AhmedDoesCS/wearable-health-monitor/docs/images/2026-01-22/1000065675.jpg

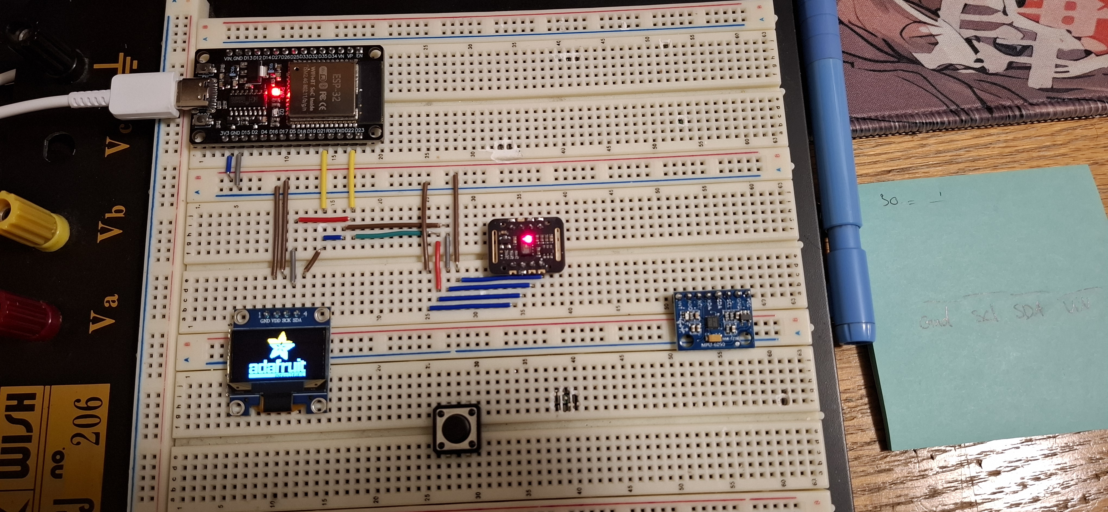
docs/images/2026-01-22/1000065675.jpg
