AhmedDoesCS/wearable-health-monitor/docs/SSD1306_notes.md

# SSD1306 — Integration Notes

## I2C Interface
- Address: 0x3C
