AhmedDoesCS/wearable-health-monitor/docs/images/2026-01-13/Schematic progress.png

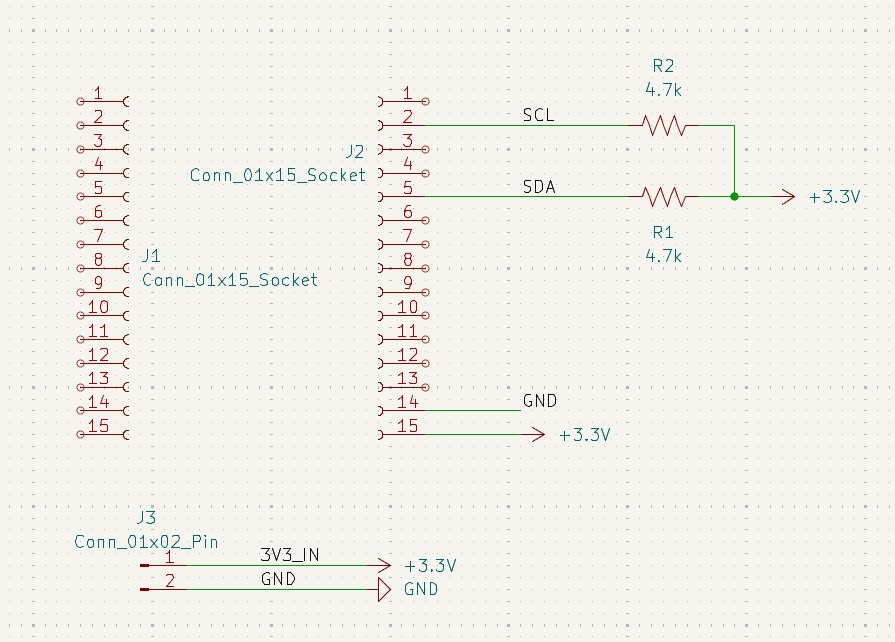
docs/images/2026-01-13/Schematic progress.png
