AhmedDoesCS/wearable-health-monitor/docs/images/2026-01-14/Schematic progress.png

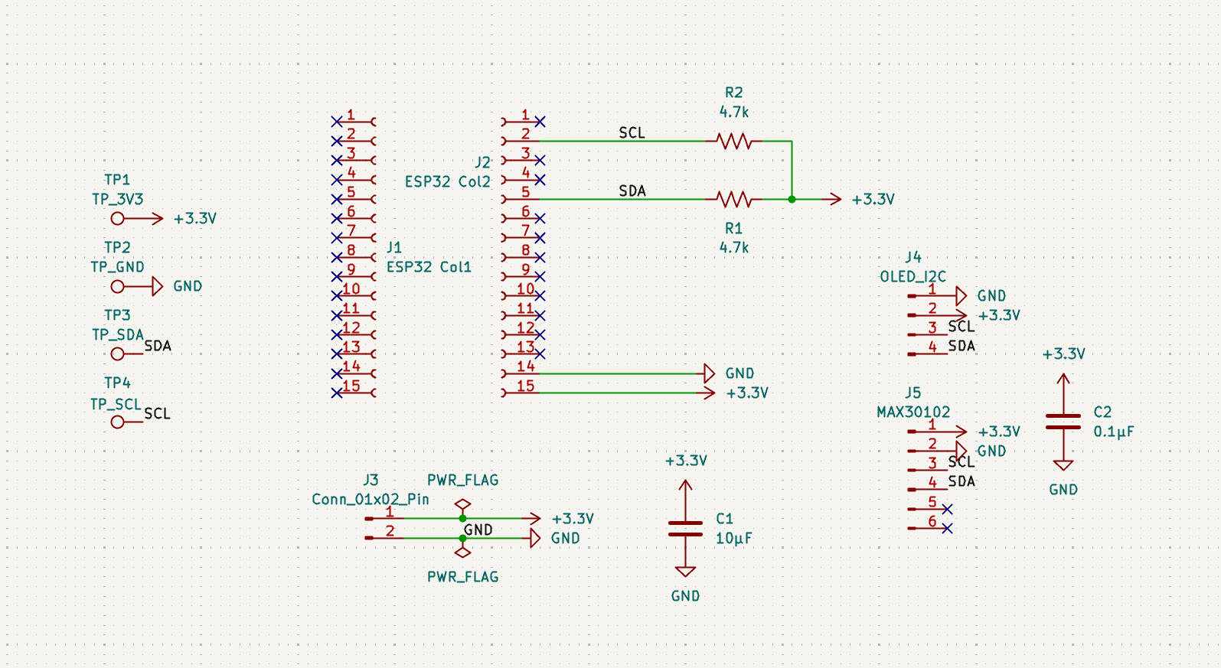
docs/images/2026-01-14/Schematic progress.png
