AhmedDoesCS/wearable-health-monitor/docs/images/2026-01-15/Assigned footprints for Rev A v1.png

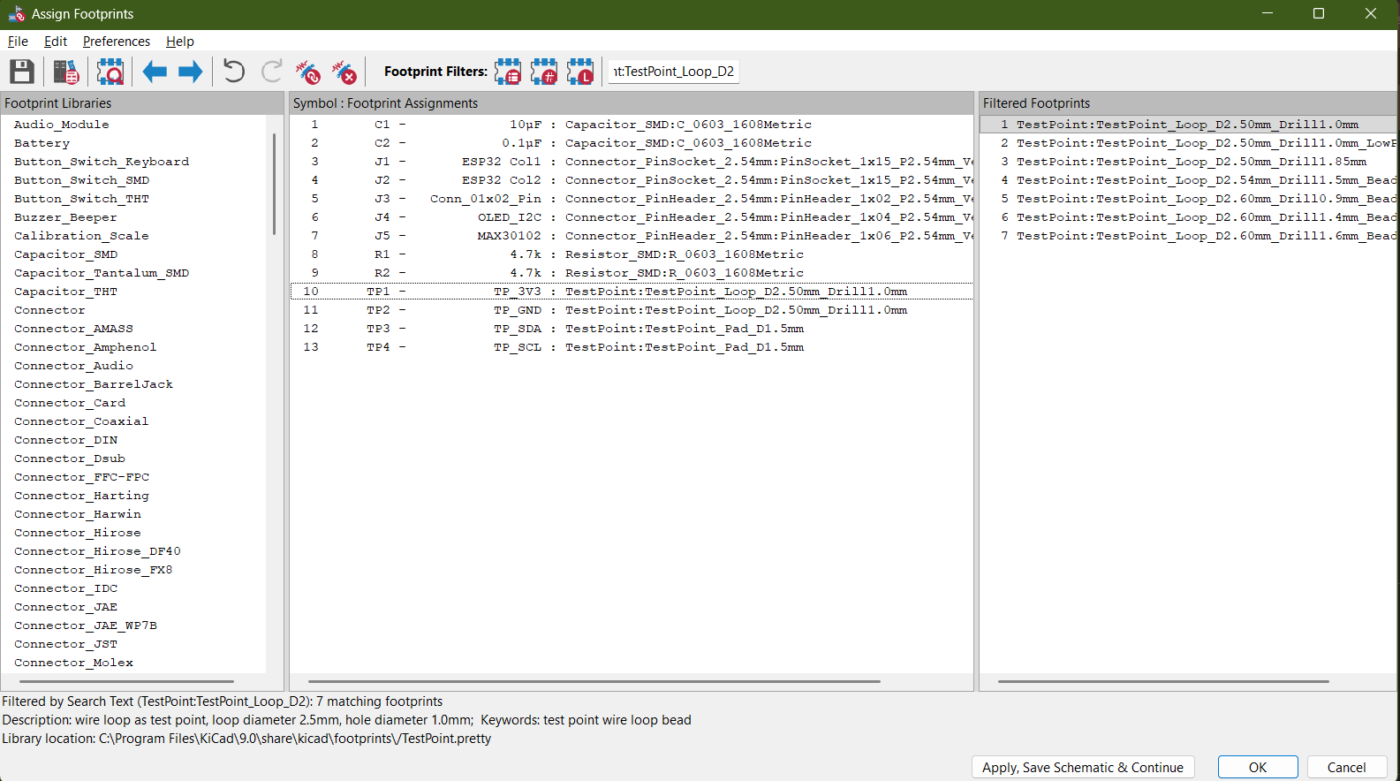
docs/images/2026-01-15/Assigned footprints for Rev A v1.png
