AhmedDoesCS/wearable-health-monitor/docs/images/2026-01-15/Rev A v1 progress 2.png

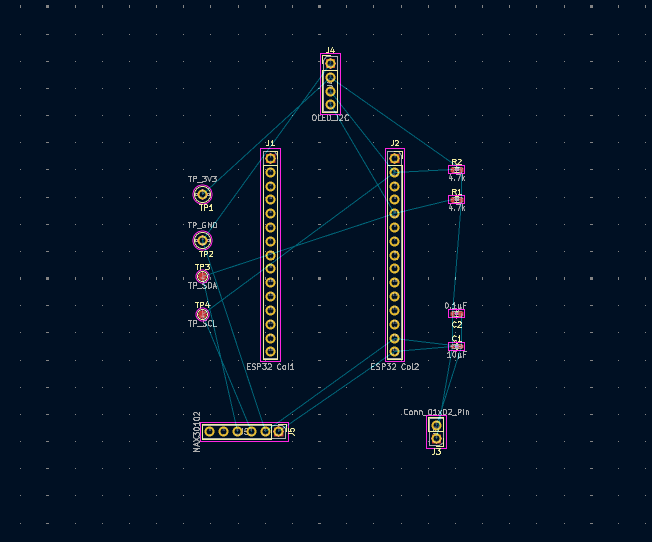
docs/images/2026-01-15/Rev A v1 progress 2.png
