AhmedDoesCS/wearable-health-monitor/docs/images/2026-01-21/1000065483.jpg

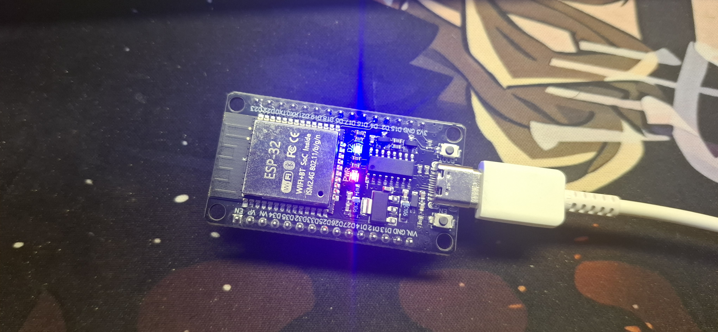
docs/images/2026-01-21/1000065483.jpg
