AhmedDoesCS/wearable-health-monitor/docs/images/2026-01-21/1000065524.jpg

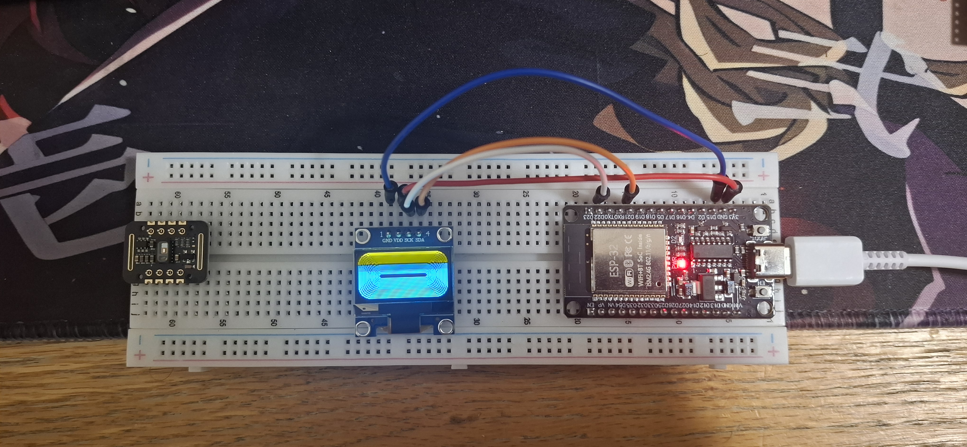
docs/images/2026-01-21/1000065524.jpg
