AhmedDoesCS/wearable-health-monitor/hardware/wearable_revB/wearable_revB/3D Models/TP4056--3DModel-STEP-56544.STEP

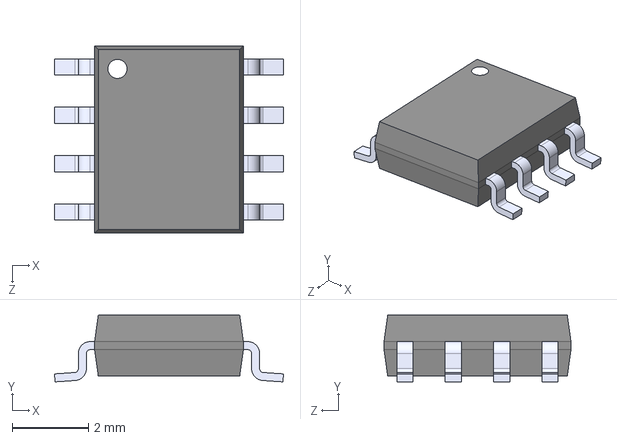
[picture p14: CAD file, 2026-07-20]
hardware/wearable_revB/wearable_revB/3D Models/TP4056--3DModel-STEP-56544.STEP
6.00 x 1.75 x 4.90 mm
