AhmedDoesCS/wearable-health-monitor/hardware/wearable_revB/wearable_revB/3D Models/MPU-6050-A.STEP

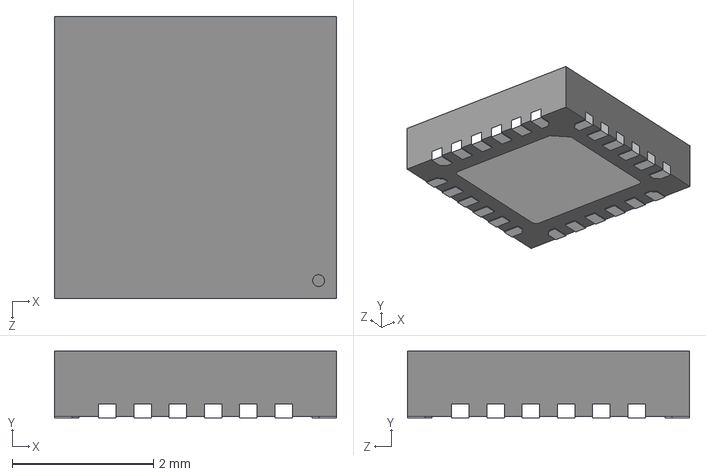
[picture p16: CAD file, 2026-07-20]
hardware/wearable_revB/wearable_revB/3D Models/MPU-6050-A.STEP
4.00 x 0.95 x 4.00 mm
