AhmedDoesCS/wearable-health-monitor/hardware/wearable_revB/wearable_revB/3D Models/3-1734839-0--3DModel-STEP-56544.STEP

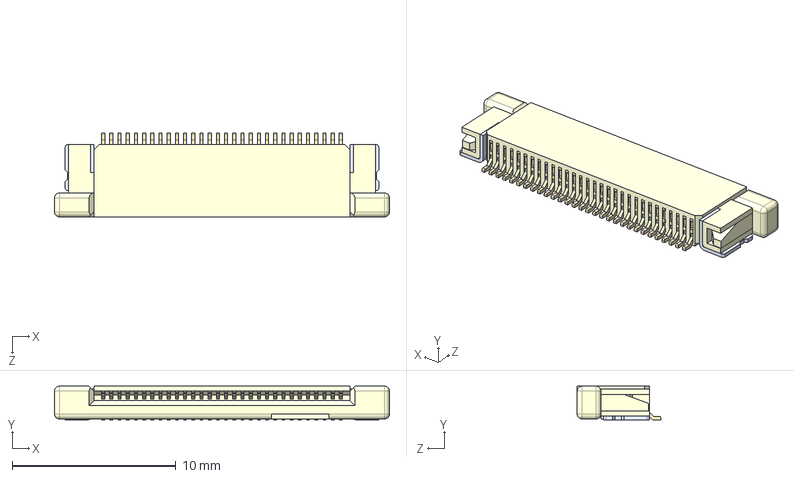
[picture p17: CAD file, 2026-07-20]
hardware/wearable_revB/wearable_revB/3D Models/3-1734839-0--3DModel-STEP-56544.STEP
20.4 x 2.05 x 5.10 mm
