AhmedDoesCS/wearable-health-monitor/hardware/wearable_revB/wearable_revB/3D Models/MAX30102EFD+T.STEP

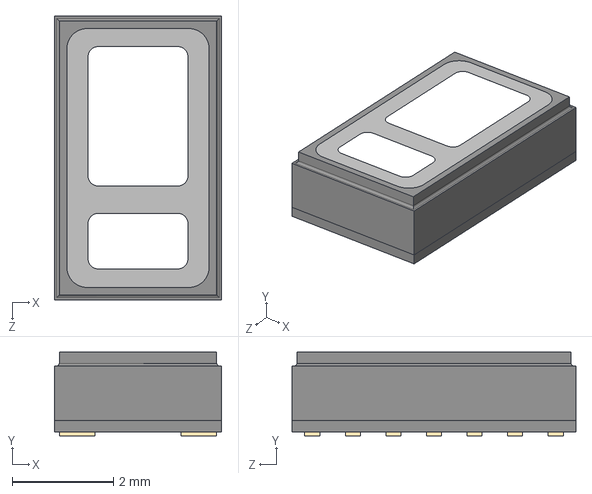
[picture p18: CAD file, 2026-07-20]
hardware/wearable_revB/wearable_revB/3D Models/MAX30102EFD+T.STEP
3.30 x 1.65 x 5.60 mm
