AhmedDoesCS/wearable-health-monitor/(list of files, cad)

Other CAD files:
hardware/wearable_revB/wearable_revB/3D Models/TP4056-42-ESOP8--3DModel-STEP-56544.STEP
