AhmedDoesCS/wearable-health-monitor/hardware/wearable_revB/wearable_revB/wearable_revB.kicad_pcb

## KiCad design hardware/wearable_revB/wearable_revB/wearable_revB.kicad_pcb (2026-07-20)

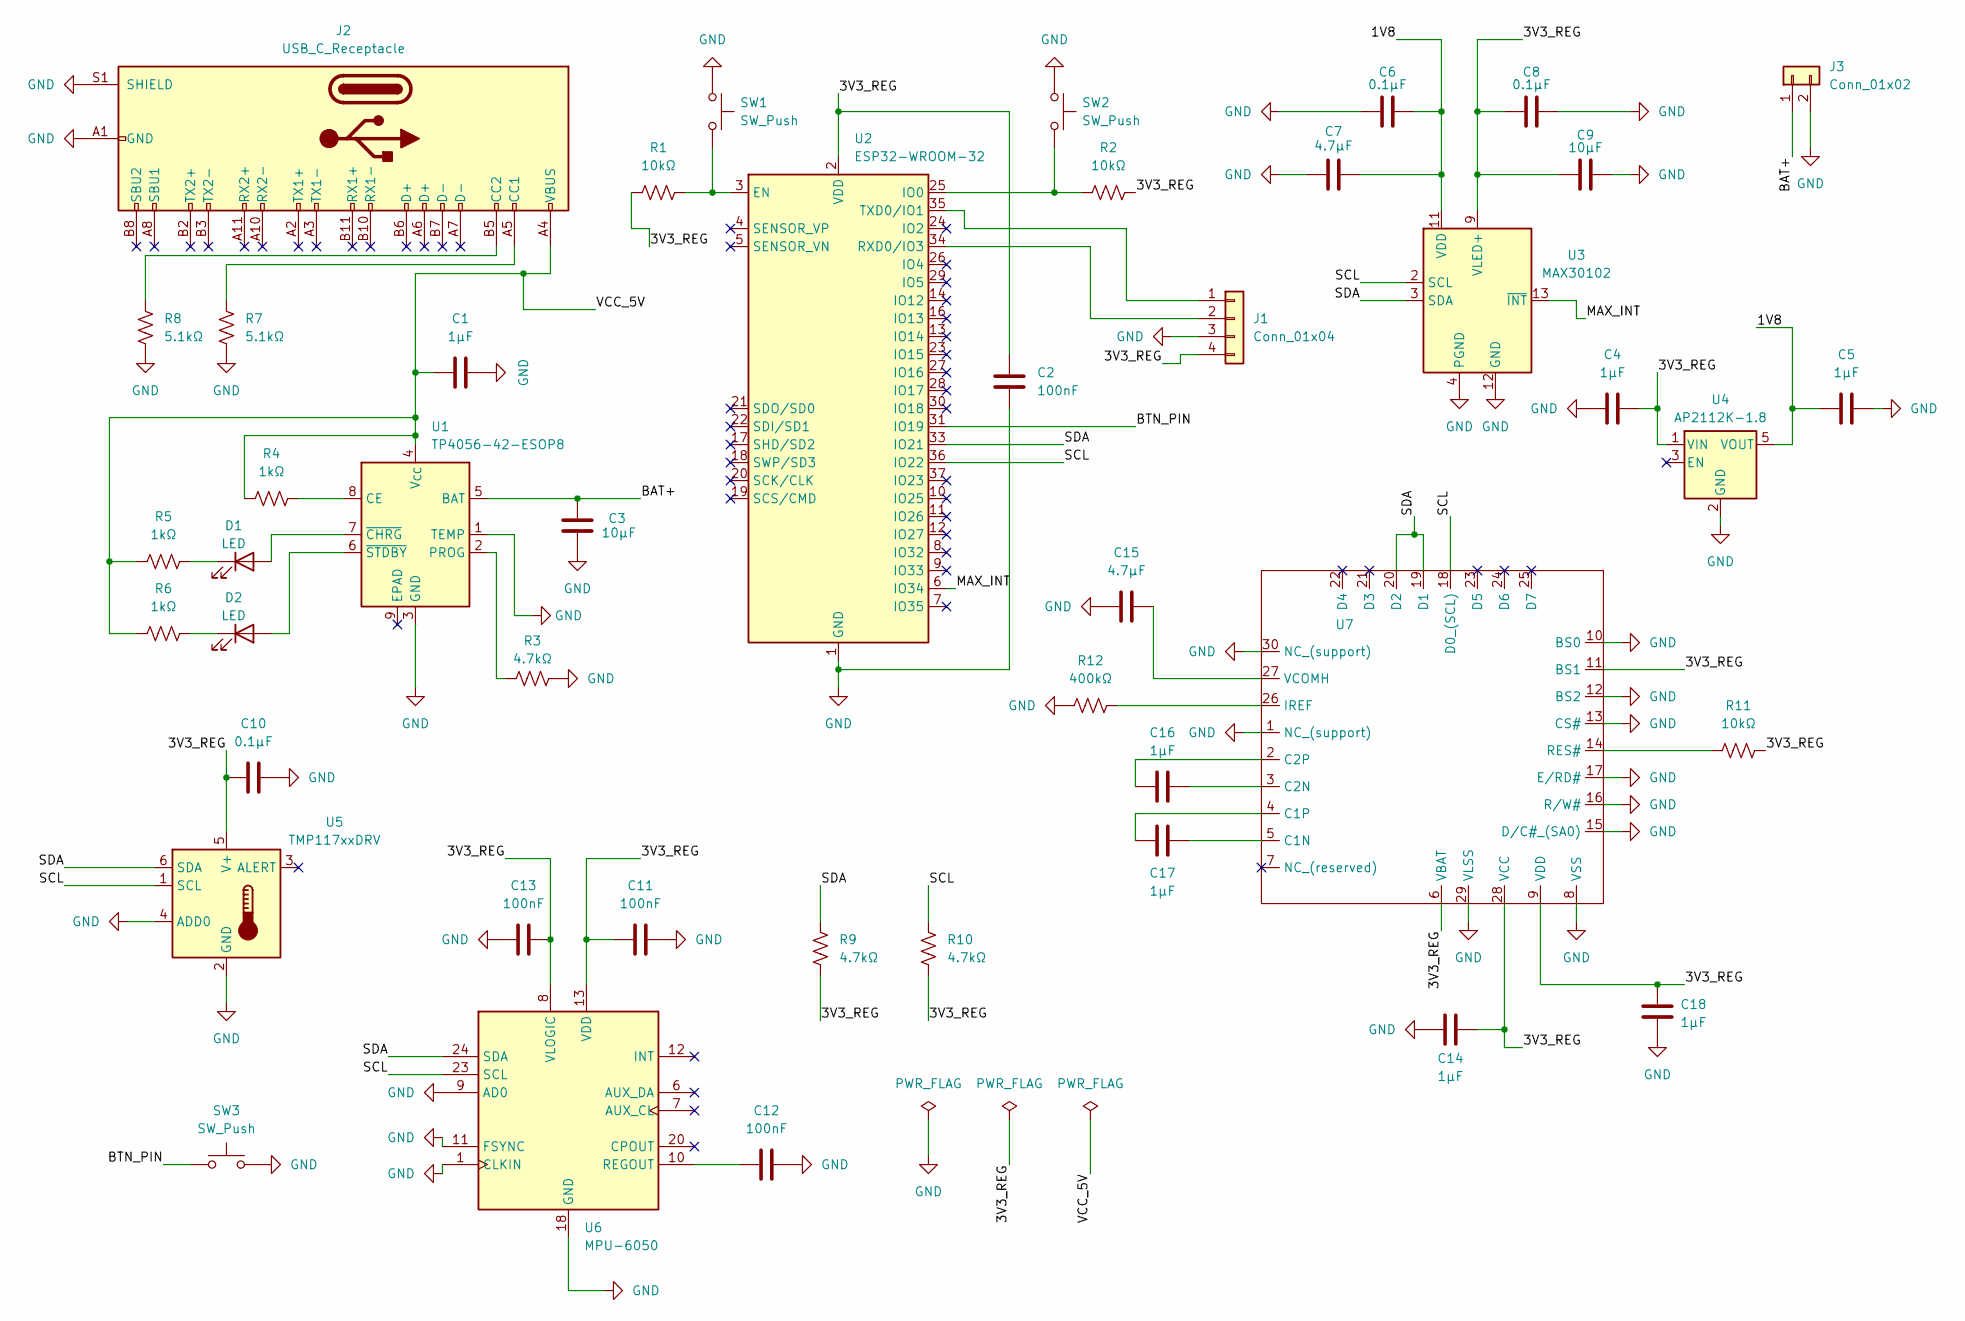
[picture p19: schematic wearable_revB.kicad_sch, DIY Health Wearable Watch]

Parts:
C1, C4, C5, C14, C16, C17, C18: 1µF; C_0603_1608Metric
C2, C11, C12, C13: 100nF; C_0603_1608Metric
C3, C9: 10µF; C_0603_1608Metric
C6, C8, C10: 0.1µF; C_0603_1608Metric
C7, C15: 4.7µF; C_0603_1608Metric
D1, D2: LED; LED_0603_1608Metric
J1: Conn_01x04; PinHeader_1x04_P1.27mm_Vertical_SMD_Pin1Left
J2: USB_C_Receptacle; USB_C_Receptacle_HRO_TYPE-C-31-M-12
J3: Conn_01x02; Battery_2Pin_THT
R1, R2, R11: 10kΩ; R_0603_1608Metric
R3, R9, R10: 4.7kΩ; R_0603_1608Metric
R4, R5, R6: 1kΩ; R_0603_1608Metric
R7, R8: 5.1kΩ; R_0603_1608Metric
R12: 400kΩ; R_0603_1608Metric
SW1, SW2: SW_Push; SW_SPST_B3U-1000P
SW3: SW_Push; SW_SPST_B3S-1100
U1: TP4056-42-ESOP8; SOIC-8-1EP_3.9x4.9mm_P1.27mm_EP2.41x3.3mm_ThermalVias
U2: ESP32-WROOM-32
U3: MAX30102; Maxim_OLGA-14_3.3x5.6mm_P0.8mm
U4: AP2112K-1.8; SOT-23-5
U5: TMP117xxDRV; WSON-6-1EP_2x2mm_P0.65mm_EP1x1.6mm
U6: MPU-6050; InvenSense_QFN-24_4x4mm_P0.5mm
U7: EASTRISING_ER-CON50HT-1

Connections:
/1V8: C5.1, C6.2, C7.1, U3.11 (VDD), U4.5 (VOUT)
/3V3_REG: C2.1, C4.2, C8.1, C9.1, C10.2, C11.1, C13.2, C14.2, C18.2, J1.4, R1.1, R2.2, R9.2, R10.2, R11.2, U2.2 (VDD), U3.9 (VLED+), U3.10 (VLED+), U4.1 (VIN), U5.5 (V+), U6.8 (VLOGIC), U6.13 (VDD), U7.6 (VBAT), U7.9 (VDD), U7.11 (BS1), U7.28 (VCC)
/BAT+: C3.1, J3.1, U1.5 (BAT)
/BTN_PIN: SW3.1, U2.31 (IO19)
/MAX_INT: U2.6 (IO34), U3.13 (~INT)
/SCL: R10.1, U2.36 (IO22), U3.2 (SCL), U5.1 (SCL), U6.23 (SCL), U7.18 (D0_(SCL))
/SDA: R9.1, U2.33 (IO21), U3.3 (SDA), U5.6 (SDA), U6.24 (SDA), U7.19 (D1), U7.20 (D2)
/VCC_5V: C1.1, J2.A4 (VBUS), J2.A9 (VBUS), J2.B4 (VBUS), J2.B9 (VBUS), R4.1, R5.1, R6.1, U1.4 (V_{CC})
GND: C1.2, C2.2, C3.2, C4.1, C5.2, C6.1, C7.2, C8.2, C9.2, C10.1, C11.2, C12.2, C13.1, C14.1, C15.1, C18.1, J1.3, J2.A1 (GND), J2.A12 (GND), J2.B1 (GND), J2.B12 (GND), J2.S1 (SHIELD), J3.2, R3.2, R7.2, R8.2, R12.1, SW1.1, SW2.1, SW3.2, U1.1 (TEMP), U1.3 (GND), U2.1 (GND), U2.15 (GND), U2.38 (GND), U2.39 (GND), U3.4 (PGND), U3.12 (GND), U4.2 (GND), U5.2 (GND), U5.4 (ADD0), U6.1 (CLKIN), U6.9 (AD0), U6.11 (FSYNC), U6.18 (GND), U7.1 (NC_(support)), U7.8 (VSS), U7.10 (BS0), U7.12 (BS2), U7.13 (CS#), U7.15 (D/C#_(SA0)), U7.16 (R/W#), U7.17 (E/RD#), U7.29 (VLSS), U7.30 (NC_(support))
unnamed: D1.2 (A), U1.7 (~CHRG)
unnamed: D1.1 (K), R5.2
unnamed: D2.2 (A), U1.6 (~STDBY)
unnamed: D2.1 (K), R6.2
unnamed: J1.1, U2.35 (TXD0/IO1)
unnamed: J1.2, U2.34 (RXD0/IO3)
unnamed: J2.A5 (CC1), R7.1
unnamed: J2.B5 (CC2), R8.1
unnamed: R4.2, U1.8 (CE)
unnamed: R3.1, U1.2 (PROG)
unnamed: R1.2, SW1.2, U2.3 (EN)
unnamed: R2.1, SW2.2, U2.25 (IO0)
unnamed: C12.1, U6.10 (REGOUT)
unnamed: C17.1, U7.5 (C1N)
unnamed: C17.2, U7.4 (C1P)
unnamed: C16.2, U7.3 (C2N)
unnamed: C16.1, U7.2 (C2P)
unnamed: R12.2, U7.26 (IREF)
unnamed: R11.1, U7.14 (RES#)
unnamed: C15.2, U7.27 (VCOMH)

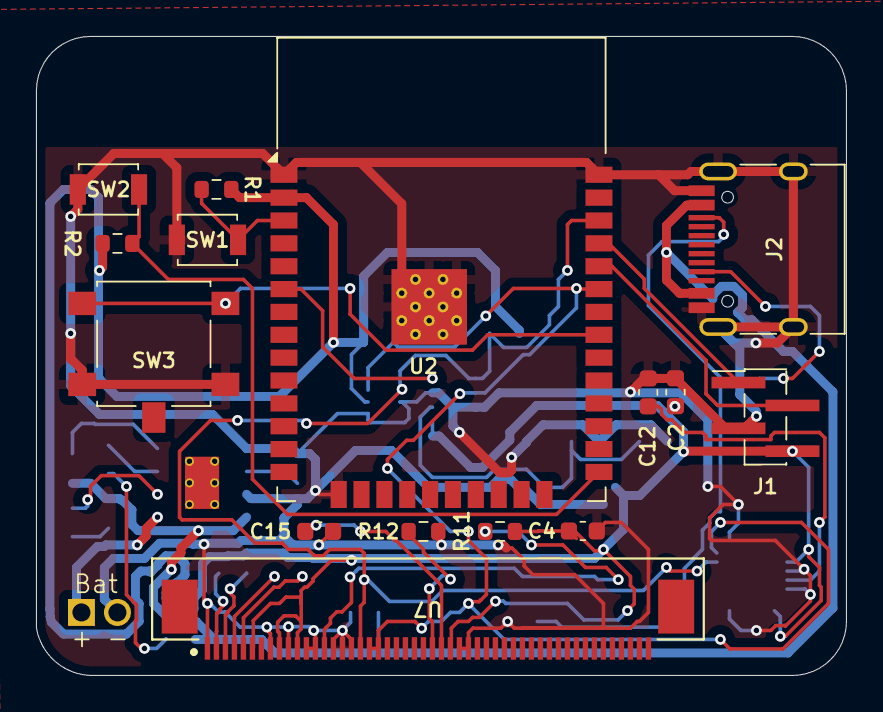
[picture p20: board wearable_revB.kicad_pcb from above]

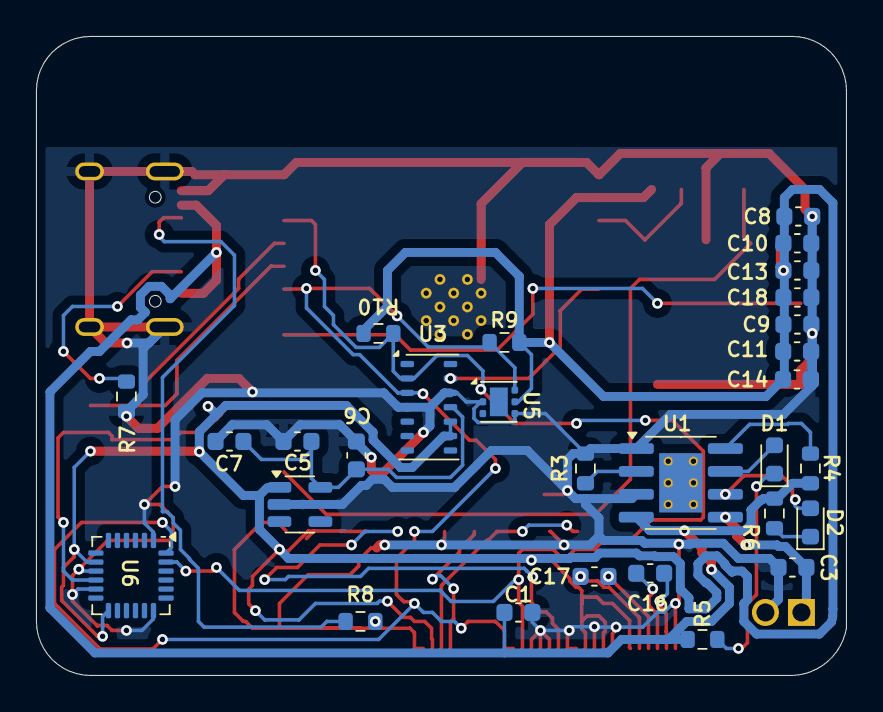
[picture p21: board wearable_revB.kicad_pcb from below]

Board: 2 copper layers, 45.0 x 35.5 mm, 45 parts (29 on the bottom side), 29 nets.
