AhmedDoesCS/wearable-health-monitor/hardware/wearable_revA/wearable_revA.kicad_pcb

## KiCad design hardware/wearable_revA/wearable_revA.kicad_pcb (2026-01-16, an earlier design)

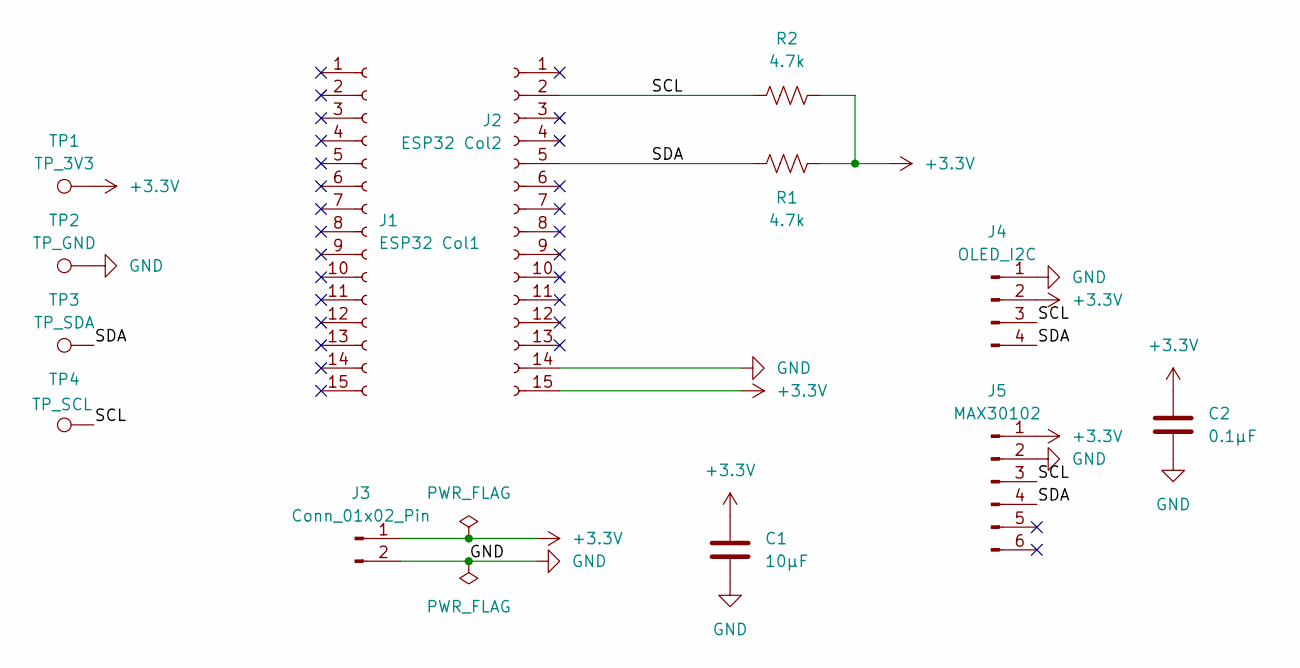
[picture p22: schematic wearable_revA.kicad_sch, Wearable Health Monitor]

Parts:
C1: 10µF; C_0603_1608Metric
C2: 0.1µF; C_0603_1608Metric
J1: ESP32 Col1; PinSocket_1x15_P2.54mm_Vertical
J2: ESP32 Col2; PinSocket_1x15_P2.54mm_Vertical
J3: Conn_01x02_Pin; PinHeader_1x02_P2.54mm_Vertical
J4: OLED_I2C; PinHeader_1x04_P2.54mm_Vertical
J5: MAX30102; PinHeader_1x06_P2.54mm_Vertical
R1, R2: 4.7k; R_0603_1608Metric
TP1: TP_3V3; TestPoint_Loop_D2.50mm_Drill1.0mm
TP2: TP_GND; TestPoint_Loop_D2.50mm_Drill1.0mm
TP3: TP_SDA; TestPoint_Pad_D1.5mm
TP4: TP_SCL; TestPoint_Pad_D1.5mm

Connections:
+3.3V: C1.1, C2.1, J2.15, J3.1, J4.2, J5.1, R1.2, R2.2, TP1.1
/SCL: J2.2, J4.3, J5.3, R2.1, TP4.1
/SDA: J2.5, J4.4, J5.4, R1.1, TP3.1
GND: C1.2, C2.2, J2.14, J3.2, J4.1, J5.2, TP2.1

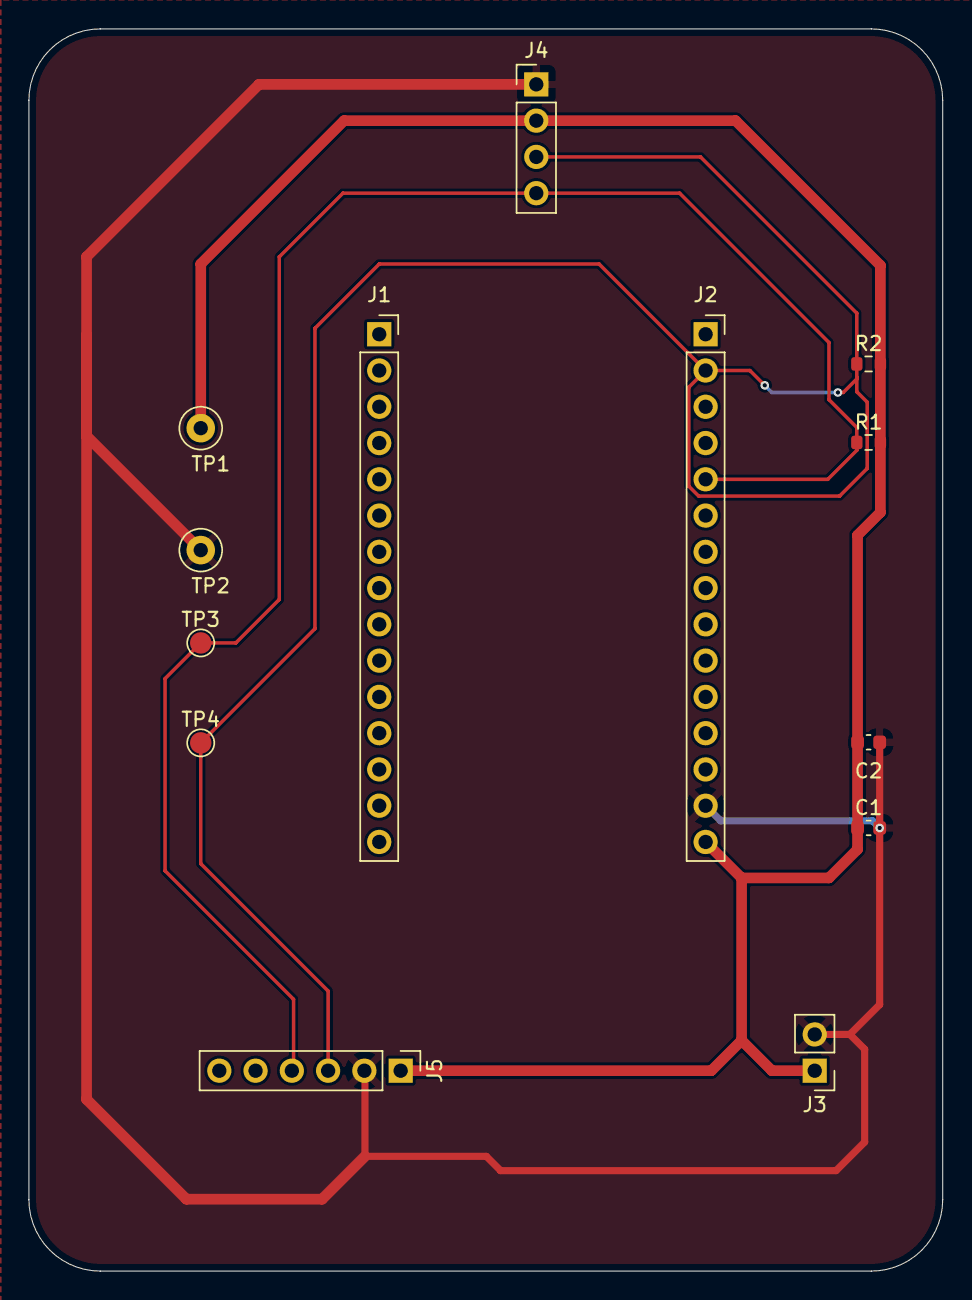
[picture p23: board wearable_revA.kicad_pcb from above]

Board: 2 copper layers, 64.0 x 87.0 mm, 13 parts (0 on the bottom side), 4 nets.
