AhmedDoesCS/wearable-health-monitor/firmware/wearable_firmware/test/test_main.cpp

#include <Arduino.h>
#include "MAX30105.h"
#include <SPI.h>
#include <Wire.h>
#include <Adafruit_GFX.h>
#include <Adafruit_SSD1306.h>
#include <SparkFun_TMP117.h> 
#include <MPU6050_light.h>

#define SCREEN_WIDTH 128  // OLED display width, in pixels
#define SCREEN_HEIGHT 64  // OLED display height, in pixels

// Declaration for an SSD1306 display connected to I2C (SDA, SCL pins)
// The pins for I2C are defined by the Wire-library.
// On an arduino UNO:       A4(SDA), A5(SCL)
// On an arduino MEGA 2560: 20(SDA), 21(SCL)
// On an arduino LEONARDO:   2(SDA),  3(SCL), ...
#define OLED_RESET -1        // Reset pin # (or -1 if sharing Arduino reset pin)
#define SCREEN_ADDRESS 0x3C  ///< See datasheet for Address; 0x3D for 128x64, 0x3C for 128x32
Adafruit_SSD1306 display(SCREEN_WIDTH, SCREEN_HEIGHT, &Wire, OLED_RESET);
MPU6050 mpu(Wire);


#define LOGO_HEIGHT 16
#define LOGO_WIDTH 16

MAX30105 particleSensor;
#define debug Serial

TMP117 sensor;  // Initalize sensor

void setup() {
  Serial.begin(9600);
  Wire.begin();
  Wire.setClock(400000);  // Used for the TMP117
  // Wait for display
  delay(500);

  byte status = mpu.begin();
  while (status != 0) {}
  mpu.calcOffsets();

  Serial.println("TMP117 Example 1: Basic Readings");
  if (sensor.begin() == true)  // Function to check if the sensor will correctly self-identify with the proper Device ID/Address
  {
    Serial.println("Begin");
  } else {
    Serial.println("Device failed to setup- Freezing code.");
    while (1)
      ;  // Runs forever
  }

  // SSD1306_SWITCHCAPVCC = generate display voltage from 3.3V internally
  if (!display.begin(SSD1306_SWITCHCAPVCC, SCREEN_ADDRESS)) {
    Serial.println(F("SSD1306 allocation failed"));
    for (;;)
      ;  // Don't proceed, loop forever
  }

  // Show initial display buffer contents on the screen --
  // the library initializes this with an Adafruit splash screen.
  display.display();
  delay(2000);  // Pause for 2 seconds

  // Clear the buffer
  display.clearDisplay();

  // Draw a single pixel in white
  display.drawPixel(10, 10, SSD1306_WHITE);

  // Show the display buffer on the screen. You MUST call display() after
  // drawing commands to make them visible on screen!
  display.display();
  delay(2000);
  // display.display() is NOT necessary after every single drawing command,
  // unless that's what you want...rather, you can batch up a bunch of
  // drawing operations and then update the screen all at once by calling
  // display.display(). These examples demonstrate both approaches...

  // Invert and restore display, pausing in-between
  display.invertDisplay(true);
  delay(1000);
  display.invertDisplay(false);
  delay(1000);

  if (particleSensor.begin() == false) {
    debug.println("MAX30105 was not found. Please check wiring/power. ");
    while (1)
      ;
  }

  particleSensor.setup();  //Configure sensor. Use 6.4mA for LED drive
  display.setTextSize(0.5);
  display.setTextColor(SSD1306_WHITE);
  display.setCursor(0, 0);
}

void loop() {
  float tempC = sensor.readTempC();
  float tempF = sensor.readTempF();
  mpu.update();

  display.clearDisplay();
  display.setCursor(0, 0);
  display.print("R[");
  display.print(particleSensor.getRed());
  display.print("]\nIR[");
  display.print(particleSensor.getIR());
  display.print("]\nG[");
  display.print(particleSensor.getGreen());
  display.print("]\n\n");

  display.print("Temp: ");
  display.print(tempC);
  display.print("C   ");
  display.print(tempF);
  display.print("F\n\n");

  display.print("AngleX: ");
  display.print(mpu.getAngleX());

  display.display();
}
