AhmedDoesCS/wearable-health-monitor/(commit log)

2026-01-13 Initialize datasheet notes for sensors
2026-01-14 Initialize Rev A hardware project Remove platformio project
    [wearable_revA.kicad_pcb, wearable_revA.kicad_sch]
2026-01-14 Update Rev A schematic Include screenshot for proof
    [wearable_revA.kicad_sch]
2026-01-15 Update schematic design Update log.md
    [wearable_revA.kicad_sch]
2026-01-16 Finalize Rev A PCB design Update log.md
    [wearable_revA.kicad_pcb, wearable_revA.kicad_sch]
2026-02-20 Develop MAX30102 and TMP117 schematics
    [wearable_revB.kicad_pcb, wearable_revB.kicad_sch]
2026-07-13 Project Restart, debug and Platformio Setup
    [wearable_revB.kicad_sch]
2026-07-14 Firmware Update + Button implementation
2026-07-15 Firmware Debugging + revB Schematic Completion
    [wearable_revB.kicad_pcb, wearable_revB.kicad_sch]
2026-07-20 Finalized PCB
    [3-1734839-0--3DModel-STEP-56544.STEP, MAX30102EFD+T.STEP, MPU-6050-A.STEP, TP4056--3DModel-STEP-56544.STEP, TP4056-42-ESOP8--3DModel-STEP-56544.STEP, TYPE-C-31-M-12--3DModel-STEP-56544.STEP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]
